MaDengler/seedcontrol_stm32/Housing/Housing_bottom.FCStd

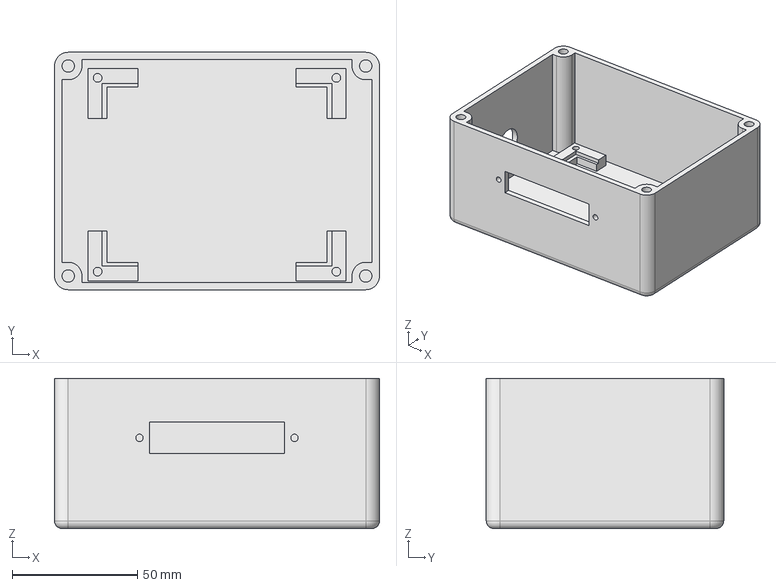
[picture p1: CAD file, 2026-04-17]
Housing/Housing_bottom.FCStd
130.0 x 95.0 x 60.0 mm
