MaDengler/seedcontrol_stm32/Housing/Housing_Clamp.FCStd

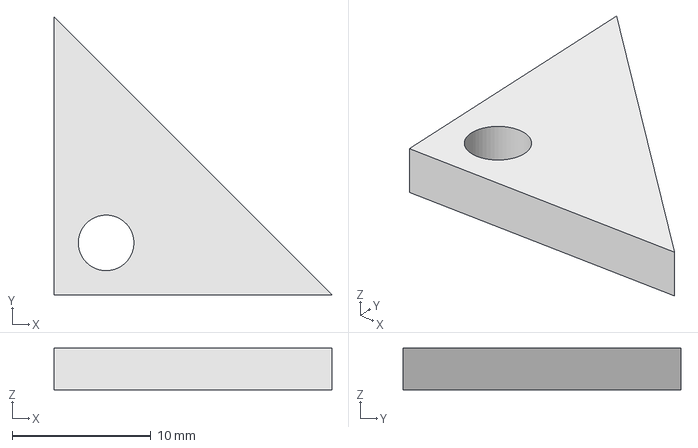
[picture p2: CAD file, 2026-04-17]
Housing/Housing_Clamp.FCStd
20.0 x 20.0 x 3.00 mm
