MaDengler/seedcontrol_stm32/Housing/Housing_top.FCStd

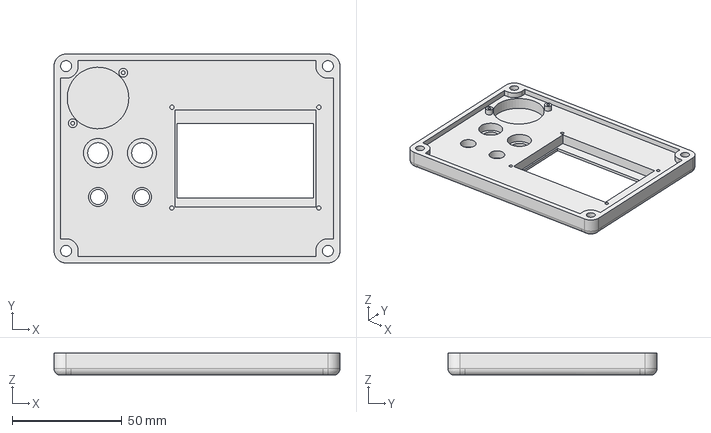
[picture p3: CAD file, 2026-04-17]
Housing/Housing_top.FCStd
130.0 x 95.0 x 10.0 mm
