MaDengler/seedcontrol_stm32/(list of files, cad)

Other CAD files:
Housing/Housing_Clamp.stl
Housing/Housing_bottom.stl
Housing/Housing_top.stl
