MaDengler/seedcontrol_stm32/BoardDesign/seedcontrol_stm32_board/seedcontrol_stm32_board.kicad_pcb

## KiCad design BoardDesign/seedcontrol_stm32_board/seedcontrol_stm32_board.kicad_pcb (2026-03-22)

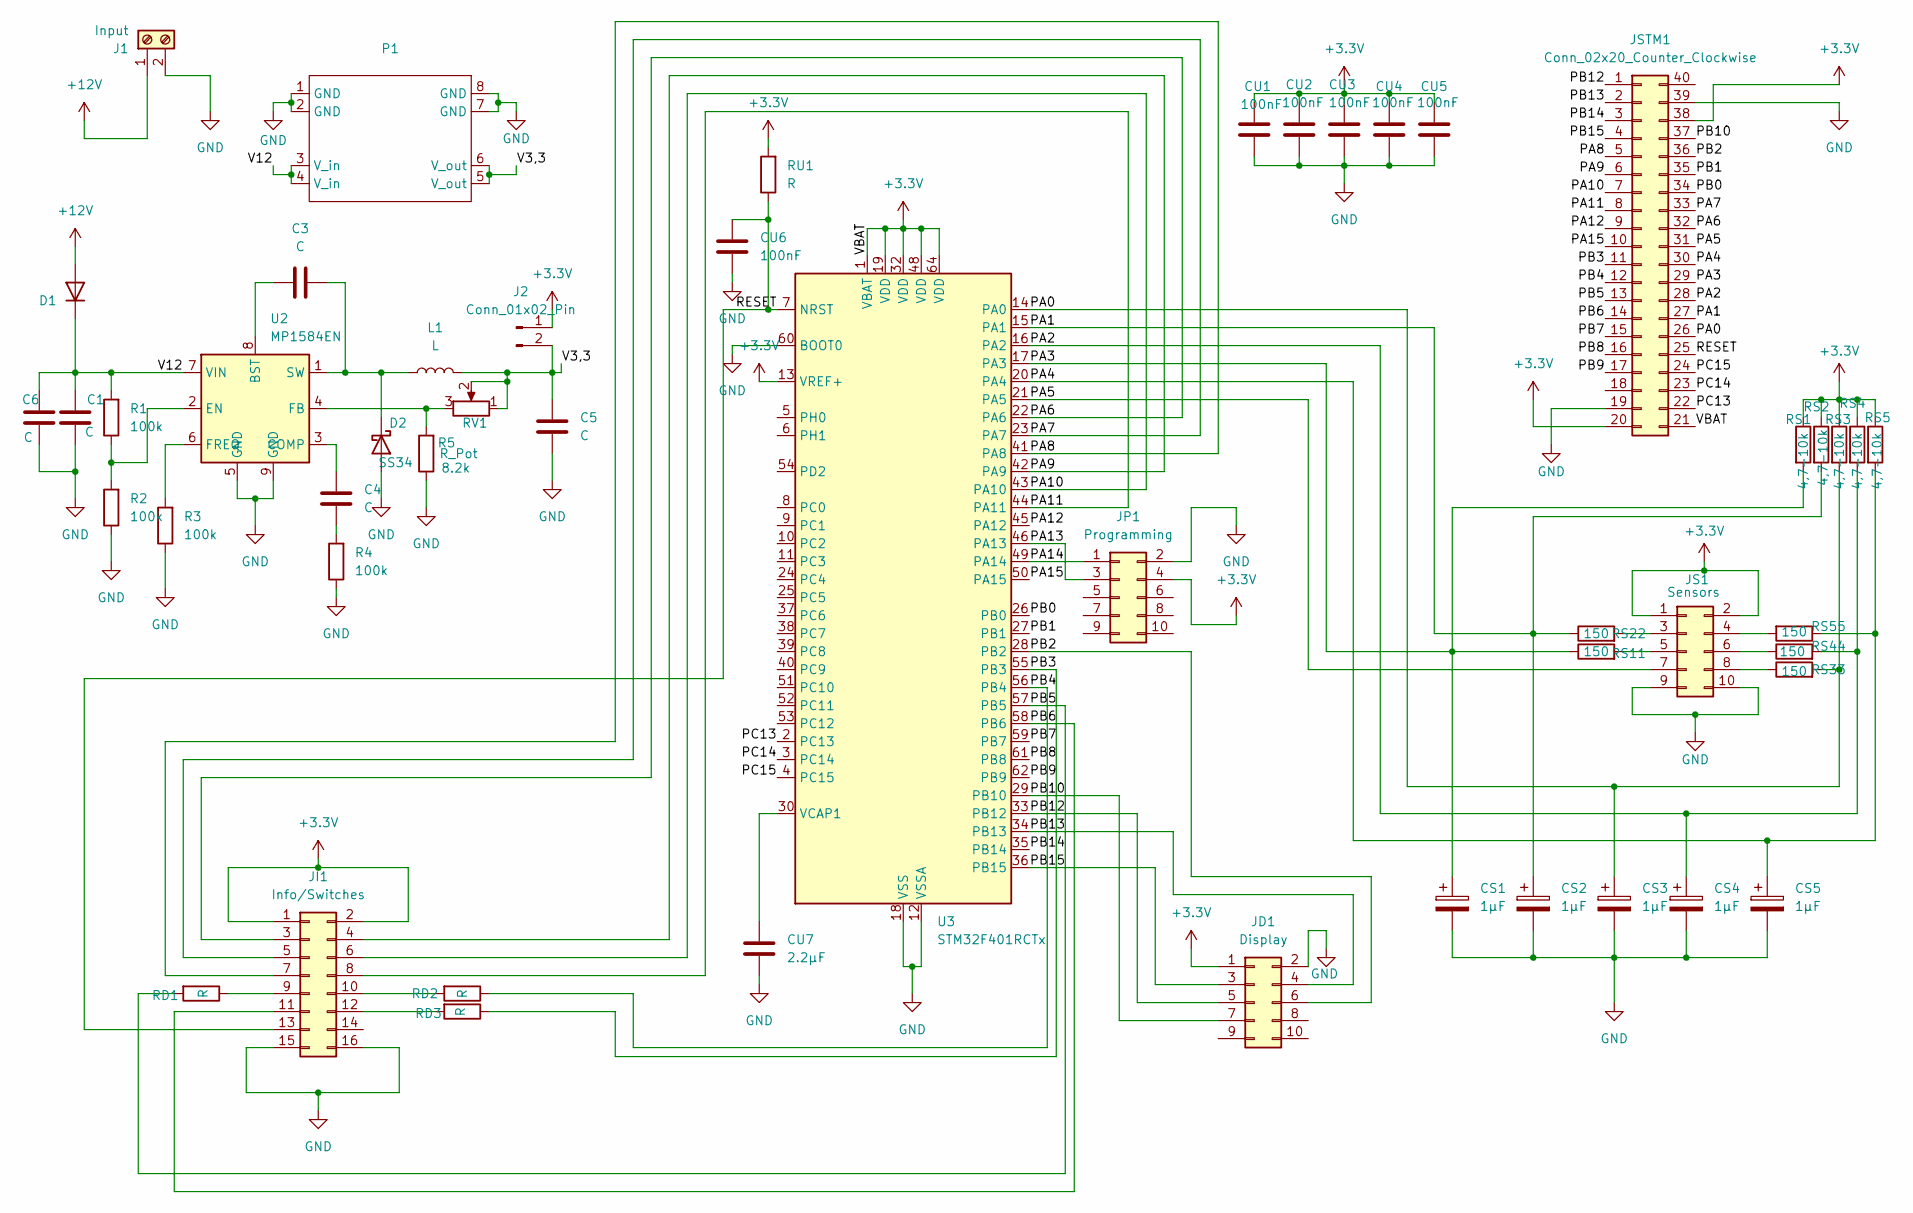
[picture p4: schematic seedcontrol_stm32_board.kicad_sch]

Parts:
C1, C3, C4: C; C_0603_1608Metric
C5, C6: C; C_1206_3216Metric
CS1, CS2, CS3, CS4, CS5: 1µF; C_Rect_L10.0mm_W3.0mm_P7.50mm_MKS4
CU1, CU2, CU3, CU4, CU5, CU6: 100nF; C_0402_1005Metric
CU7: 2.2µF; C_0402_1005Metric
D1: D_DO-41_SOD81_P12.70mm_Horizontal
D2: SS34; D_SMA
J1: Input; TerminalBlock_Altech_AK300-2_P5.00mm
J2: Conn_01x02_Pin; PinHeader_1x02_P2.54mm_Vertical
JD1: Display; PinHeader_2x05_P2.54mm_Vertical
JI1: Info/Switches; PinHeader_2x08_P2.54mm_Vertical
JP1: Programming; PinHeader_2x05_P2.54mm_Vertical
JS1: Sensors; PinHeader_2x05_P2.54mm_Vertical
JSTM1: Conn_02x20_Counter_Clockwise; STM32_Blackpill_header
L1: L; L_Bourns_SRP7028A_7.3x6.6mm
P1: Voltage_converter
R1, R2, R3, R4: 100k; R_0603_1608Metric
R5: 8.2k; R_0603_1608Metric
RD1, RD2, RD3: R; R_0603_1608Metric
RS1, RS2, RS3, RS4, RS5: 4,7-10k; R_Axial_DIN0309_L9.0mm_D3.2mm_P12.70mm_Horizontal
RS11, RS22, RS33, RS44, RS55: 150; R_Axial_DIN0309_L9.0mm_D3.2mm_P12.70mm_Horizontal
RU1: R; R_0603_1608Metric
RV1: R_Pot; Potentiometer_Bourns_TC33X_Vertical
U2: MP1584EN; SOIC-8-1EP_3.9x4.9mm_P1.27mm_EP2.62x3.51mm
U3: STM32F401RCTx; LQFP-64_10x10mm_P0.5mm

Connections:
+3.3V: CU1.2, CU2.2, CU3.2, CU4.2, CU5.2, J2.1, JD1.1, JI1.1, JI1.2, JP1.4, JS1.1, JS1.2, JSTM1.20, JSTM1.21, JSTM1.38, RS1.1, RS2.1, RS3.1, RS4.1, RS5.1, RU1.2, U3.1 (VBAT), U3.13 (VREF+), U3.19 (VDD), U3.32 (VDD), U3.48 (VDD), U3.64 (VDD)
+12V: D1.1 (A), J1.1
/PA0: CS3.1, JSTM1.26, RS3.2, RS33.2, U3.14 (PA0)
/PA1: CS2.1, JSTM1.27, RS2.2, RS22.1, U3.15 (PA1)
/PA2: CS4.1, JSTM1.28, RS4.2, RS44.2, U3.16 (PA2)
/PA3: CS1.1, JSTM1.29, RS1.2, RS11.1, U3.17 (PA3)
/PA4: CS5.1, JSTM1.30, RS5.2, RS55.1, U3.20 (PA4)
/PA5: JS1.7, JSTM1.31, U3.21 (PA5)
/PA6: JI1.3, JSTM1.32, U3.22 (PA6)
/PA7: JI1.5, JSTM1.33, U3.23 (PA7)
/PA8: JI1.7, JSTM1.5, U3.41 (PA8)
/PA9: JI1.4, JSTM1.6, U3.42 (PA9)
/PA10: JI1.6, JSTM1.7, U3.43 (PA10)
/PA11: JI1.8, JSTM1.8, U3.44 (PA11)
/PA12: JSTM1.9, U3.45 (PA12)
/PA13: JP1.3, U3.46 (PA13)
/PA14: JP1.1, U3.49 (PA14)
/PA15: JSTM1.10, U3.50 (PA15)
/PB0: JSTM1.34, U3.26 (PB0)
/PB1: JSTM1.35, U3.27 (PB1)
/PB2: JD1.6, JSTM1.36, U3.28 (PB2)
/PB3: JSTM1.11, RD3.1, U3.55 (PB3)
/PB4: JSTM1.12, RD2.1, U3.56 (PB4)
/PB5: JSTM1.13, RD1.2, U3.57 (PB5)
/PB6: JI1.11, JSTM1.14, U3.58 (PB6)
/PB7: JSTM1.15, U3.59 (PB7)
/PB8: JSTM1.16, U3.61 (PB8)
/PB9: JSTM1.17, U3.62 (PB9)
/PB10: JD1.7, JSTM1.37, U3.29 (PB10)
/PB12: JD1.5, JSTM1.1, U3.33 (PB12)
/PB13: JD1.4, JSTM1.2, U3.34 (PB13)
/PB14: JSTM1.3, U3.35 (PB14)
/PB15: JD1.3, JSTM1.4, U3.36 (PB15)
/PC13: JSTM1.22, U3.2 (PC13)
/PC14: JSTM1.23, U3.3 (PC14)
/PC15: JSTM1.24, U3.4 (PC15)
/RESET: CU6.2, JI1.13, JSTM1.25, RU1.1, U3.7 (NRST)
/V3,3: C5.2, J2.2, L1.2, P1.5 (V_out), P1.6 (V_out), RV1.1, RV1.2
/V12: C1.2, C6.2, D1.2 (K), P1.3 (V_in), P1.4 (V_in), R1.2, U2.7 (VIN)
GND: C1.1, C5.1, C6.1, CS1.2, CS2.2, CS3.2, CS4.2, CS5.2, CU1.1, CU2.1, CU3.1, CU4.1, CU5.1, CU6.1, CU7.1, D2.2 (A), J1.2, JD1.2, JI1.15, JI1.16, JP1.2, JS1.9, JS1.10, JSTM1.19, JSTM1.39, P1.1 (GND), P1.2 (GND), P1.7 (GND), P1.8 (GND), R2.1, R3.1, R4.1, R5.1, U2.5 (GND), U2.9 (GND), U3.12 (VSSA), U3.18 (VSS), U3.31 (VSS), U3.47 (VSS), U3.60 (BOOT0), U3.63 (VSS)
unnamed: C4.1, R4.2
unnamed: C3.2, D2.1 (K), L1.1, U2.1 (SW)
unnamed: JI1.9, RD1.1
unnamed: JI1.10, RD2.2
unnamed: JI1.12, RD3.2
unnamed: JS1.3, RS22.2
unnamed: JS1.4, RS55.2
unnamed: JS1.5, RS11.2
unnamed: JS1.6, RS44.1
unnamed: JS1.8, RS33.1
unnamed: C3.1, U2.8 (BST)
unnamed: C4.2, U2.3 (COMP)
unnamed: R1.1, R2.2, U2.2 (EN)
unnamed: R5.2, RV1.3, U2.4 (FB)
unnamed: R3.2, U2.6 (FREQ)
unnamed: CU7.2, U3.30 (VCAP1)

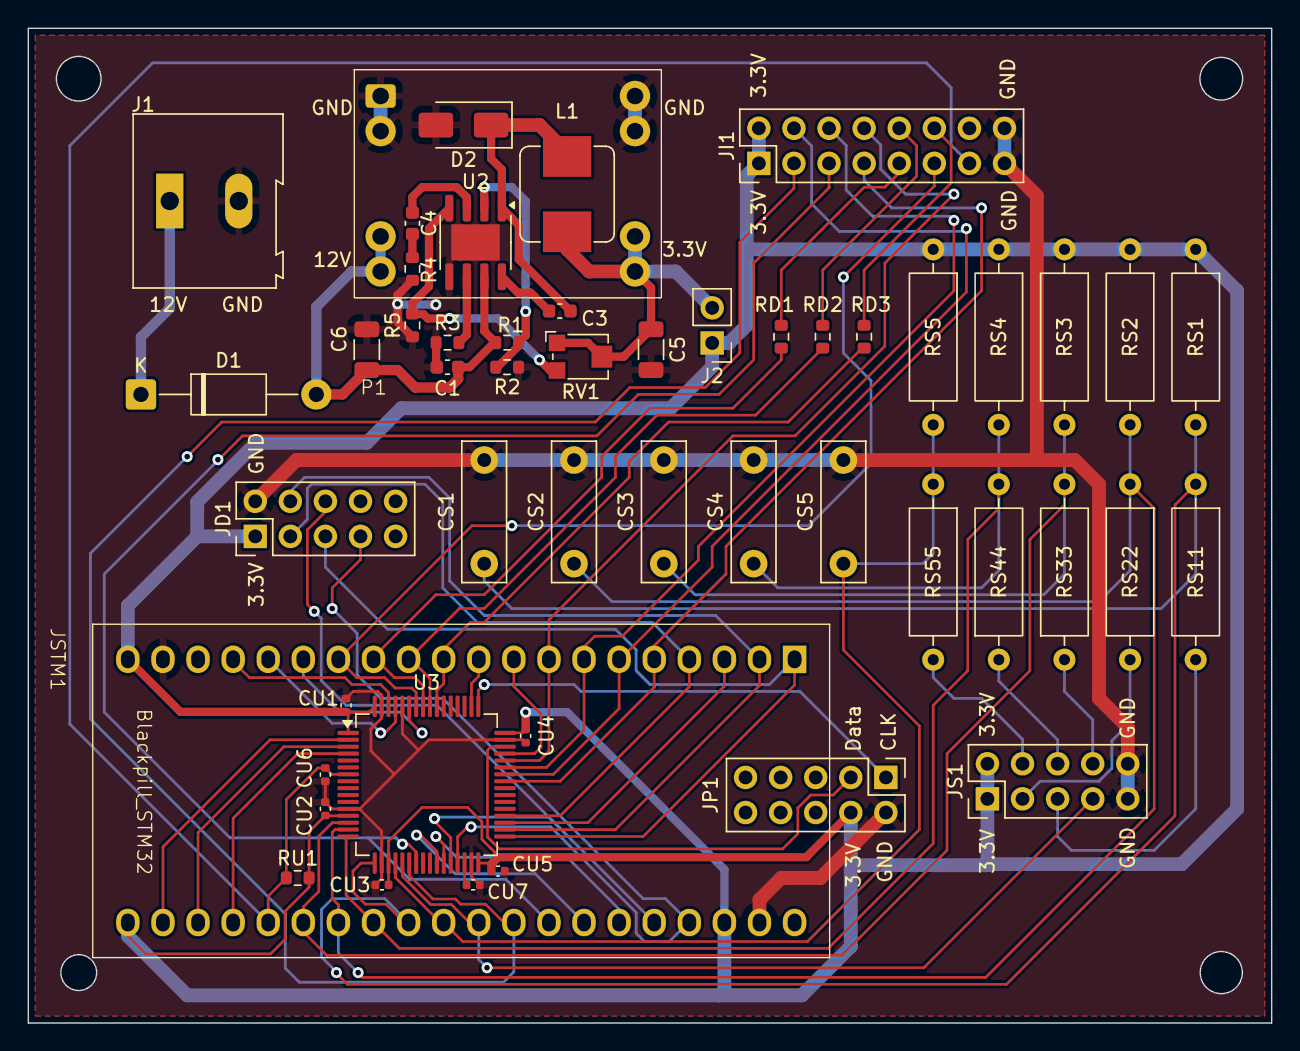
[picture p5: board seedcontrol_stm32_board.kicad_pcb from above]

Board: 2 copper layers, 90.0 x 72.0 mm, 50 parts (0 on the bottom side), 56 nets.
