MaDengler/seedcontrol_stm32/Program/src/symbols.c

#include "symbols.h"


const struct Symbol symbolFan = {
	.size=72,
	.pixels={
0xff,0xc3,0xff,0x7f,0x7e,0xfe,0x9f,0x0f,0xfb,0xef,0x0f,0xf6,0x17,0x0e,0xee,0x0b,0x0c,0xde,0x03,0x0c,0xfe,0x05,0x08,0x87,0x3d,0x00,0x83,0xff,0x98,0xc1,0xfe,0x01,0x40,0x06,0x42,0x40,0x02,0x42,0x60,0x02,0x80,0x7f,0x83,0x19,0xff,0xc1,0x00,0xbc,0xe5,0x10,0xa0,0x7b,0x30,0xe0,0x7b,0x30,0xd0,0x77,0x70,0xe8,0x6f,0xf0,0xf7,0x9f,0xf0,0xfb,0x7f,0x7e,0xfe,0xff,0xc3,0xff
	}
};

const struct Symbol symbolSeeder1 = {
	.size=60,
	.pixels={
0xff,0xff,0xff,0xff,0xff,0xff,0xff,0xff,0xff,0xff,0xff,0xff,0xff,0xe1,0xff,0xff,0xe0,0xff,0x7f,0xe0,0xff,0x3f,0xe0,0xff,0x1f,0xf0,0xff,0x0f,0xf8,0xff,0x07,0xfc,0xff,0x03,0x00,0xc0,0x03,0x00,0xc0,0x03,0x00,0xc0,0x03,0x00,0xc0,0x03,0x00,0xc0,0xff,0xff,0xff,0xff,0xff,0xff,0xff,0xff,0xff,0xff,0xff,0xff
	}
};
const struct Symbol symbolSeeder2 = {
	.size=60,
	.pixels={
0xff,0xff,0xff,0xff,0xff,0xff,0xff,0xff,0xff,0x3f,0xfc,0xc3,0x1f,0xfc,0xc1,0x0f,0xfc,0xc0,0x07,0x7c,0xc0,0x07,0x3e,0xc0,0x03,0x1f,0xc0,0x03,0x0f,0xc0,0x03,0x07,0xc0,0x03,0x00,0xc2,0x07,0x00,0xc3,0x07,0x80,0xc3,0x0f,0xc0,0xc3,0x1f,0xc0,0xc3,0x7f,0xf0,0xc3,0xff,0xff,0xff,0xff,0xff,0xff,0xff,0xff,0xff
	}
};
const struct Symbol symbolSeeder3 = {
	.size=60,
	.pixels={
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
	0x00, 0x00, 0x00, 0x00, 0x00, 0x00, 0x00, 0x00, 0x00, 0x00, 0x00, 0x00,
	0x00, 0x00, 0x00, 0x00, 0x00, 0x00, 0x00, 0x00, 0x00, 0x00, 0x00, 0x00,
	0x00, 0x00, 0x00, 0x00, 0x00, 0x00, 0x00, 0x00, 0x00, 0x00, 0x00, 0x00,
	0x00, 0x00, 0x00, 0x00, 0x00, 0x00, 0x00, 0x00, 0x00, 0x00, 0x00, 0x00
	}
};
