MaDengler/seedcontrol_stm32/Program/inc/symbols.h

//Store symbols to be displayed as array of pixels in the flash memory

struct Symbol{
	char size; 
	char pixels[72];
};

		
extern const struct Symbol symbolFan;
extern const struct Symbol symbolFanInverted;

extern const struct Symbol symbolSeeder1;
extern const struct Symbol symbolSeeder2;
extern const struct Symbol symbolSeeder3;
extern const struct Symbol symbolSeeder4;

extern const struct Symbol symbolWheel;

extern const struct Symbol digit0;
extern const struct Symbol digit1;
extern const struct Symbol digit2;
extern const struct Symbol digit3;
extern const struct Symbol digit4;
extern const struct Symbol digit5;
extern const struct Symbol digit6;
extern const struct Symbol digit7;
extern const struct Symbol digit8;
extern const struct Symbol digit9;
extern const struct Symbol symbolComma;
extern const struct Symbol symbolClear60;
extern const struct Symbol symbolClear72;
extern const struct Symbol symbolClearDigit;
extern const struct Symbol symbolKMH;
extern const struct Symbol symbolUmin;
extern const struct Symbol symbolHa;
extern const struct Symbol symbolHaTot;
