MaDengler/seedcontrol_stm32/(commit log)

2025-03-14 Initial commit. Set up project structure and Build with Makefile. Example program that blinks an LED connected to Pin C13 working
2025-03-16 Changed main such that the fan-symbol is blinking on display
2025-03-16 Adjusted SPI initialisation
2025-03-19 Adjusted SPI baudrate such that communication is more stable. No display errors could be observed with the new baudrate.
    [display.c, main.c]
2025-03-20 Started designing of the board. Added status struct that holds the current state of the machine.
    [seedcontrol_stm32_board.kicad_pcb, seedcontrol_stm32_board.kicad_sch]
2025-03-30 Added KiCAD schematic of the board and startet designing the PCB layout.
    [seedcontrol_stm32_board.kicad_pcb, seedcontrol_stm32_board.kicad_sch]
2025-04-06 Finalized board layout.
    [seedcontrol_stm32_board.kicad_pcb, seedcontrol_stm32_board.kicad_sch]
2025-04-16 Interrupts and timers are working as expected and state is displayed correxctly. Alarm, status LEDs and prsisting of the counter states needs to be implemented.
2026-03-11 Changed board design. Added footprint for STM32_Blackpill connector.
    [seedcontrol_stm32_board.kicad_pcb, seedcontrol_stm32_board.kicad_sch]
2026-03-14 Finalized schematics. Placed all components in Boardview.
    [seedcontrol_stm32_board.kicad_pcb, seedcontrol_stm32_board.kicad_sch]
2026-03-22 Final Board design.
    [seedcontrol_stm32_board.kicad_pcb, seedcontrol_stm32_board.kicad_sch]
2026-03-26 Reworked persist logic such that the whole sector 5 is used in oder to reduce number of erasions.
    [display.c, display.h, main.c, persist.c, state.c, state.h]
2026-04-06 Persist does now not erase on every write to flash. Also issues with false alarms have been eliminated by considering the previous seederStates and adding alarm prevent during the first wheel rotatio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
    [display.c, display.h, main.c, persist.c, state.c, state.h]
2026-04-07 Moved initialisation of state struct into state_init. Optimized button press and alarm, such that no delays block the main loop.
2026-04-10 Added mute for the alarm tone for the whole cycle by longpressing the button in alarm state.
2026-04-17 Copied Freecad design folder for the housing from previous seedcontrol project into here.
    [Housing_Clamp.FCStd, Housing_Clamp.stl, Housing_bottom.FCStd, Housing_bottom.stl, Housing_top.FCStd, Housing_top.stl]
